SeniorDesign-2024/ControlBoard_Hardware/README.txt

Senior Design Control Board

The purpose of this board is to interface with all the different subsystems and manage inputs and outputs to and from the user.
