SeniorDesign-2024/ControlBoard_Hardware/ControlBoard_Hardware/ControlBoard_Hardware.kicad_pcb

## KiCad design ControlBoard_Hardware/ControlBoard_Hardware.kicad_pcb (2024-02-27)

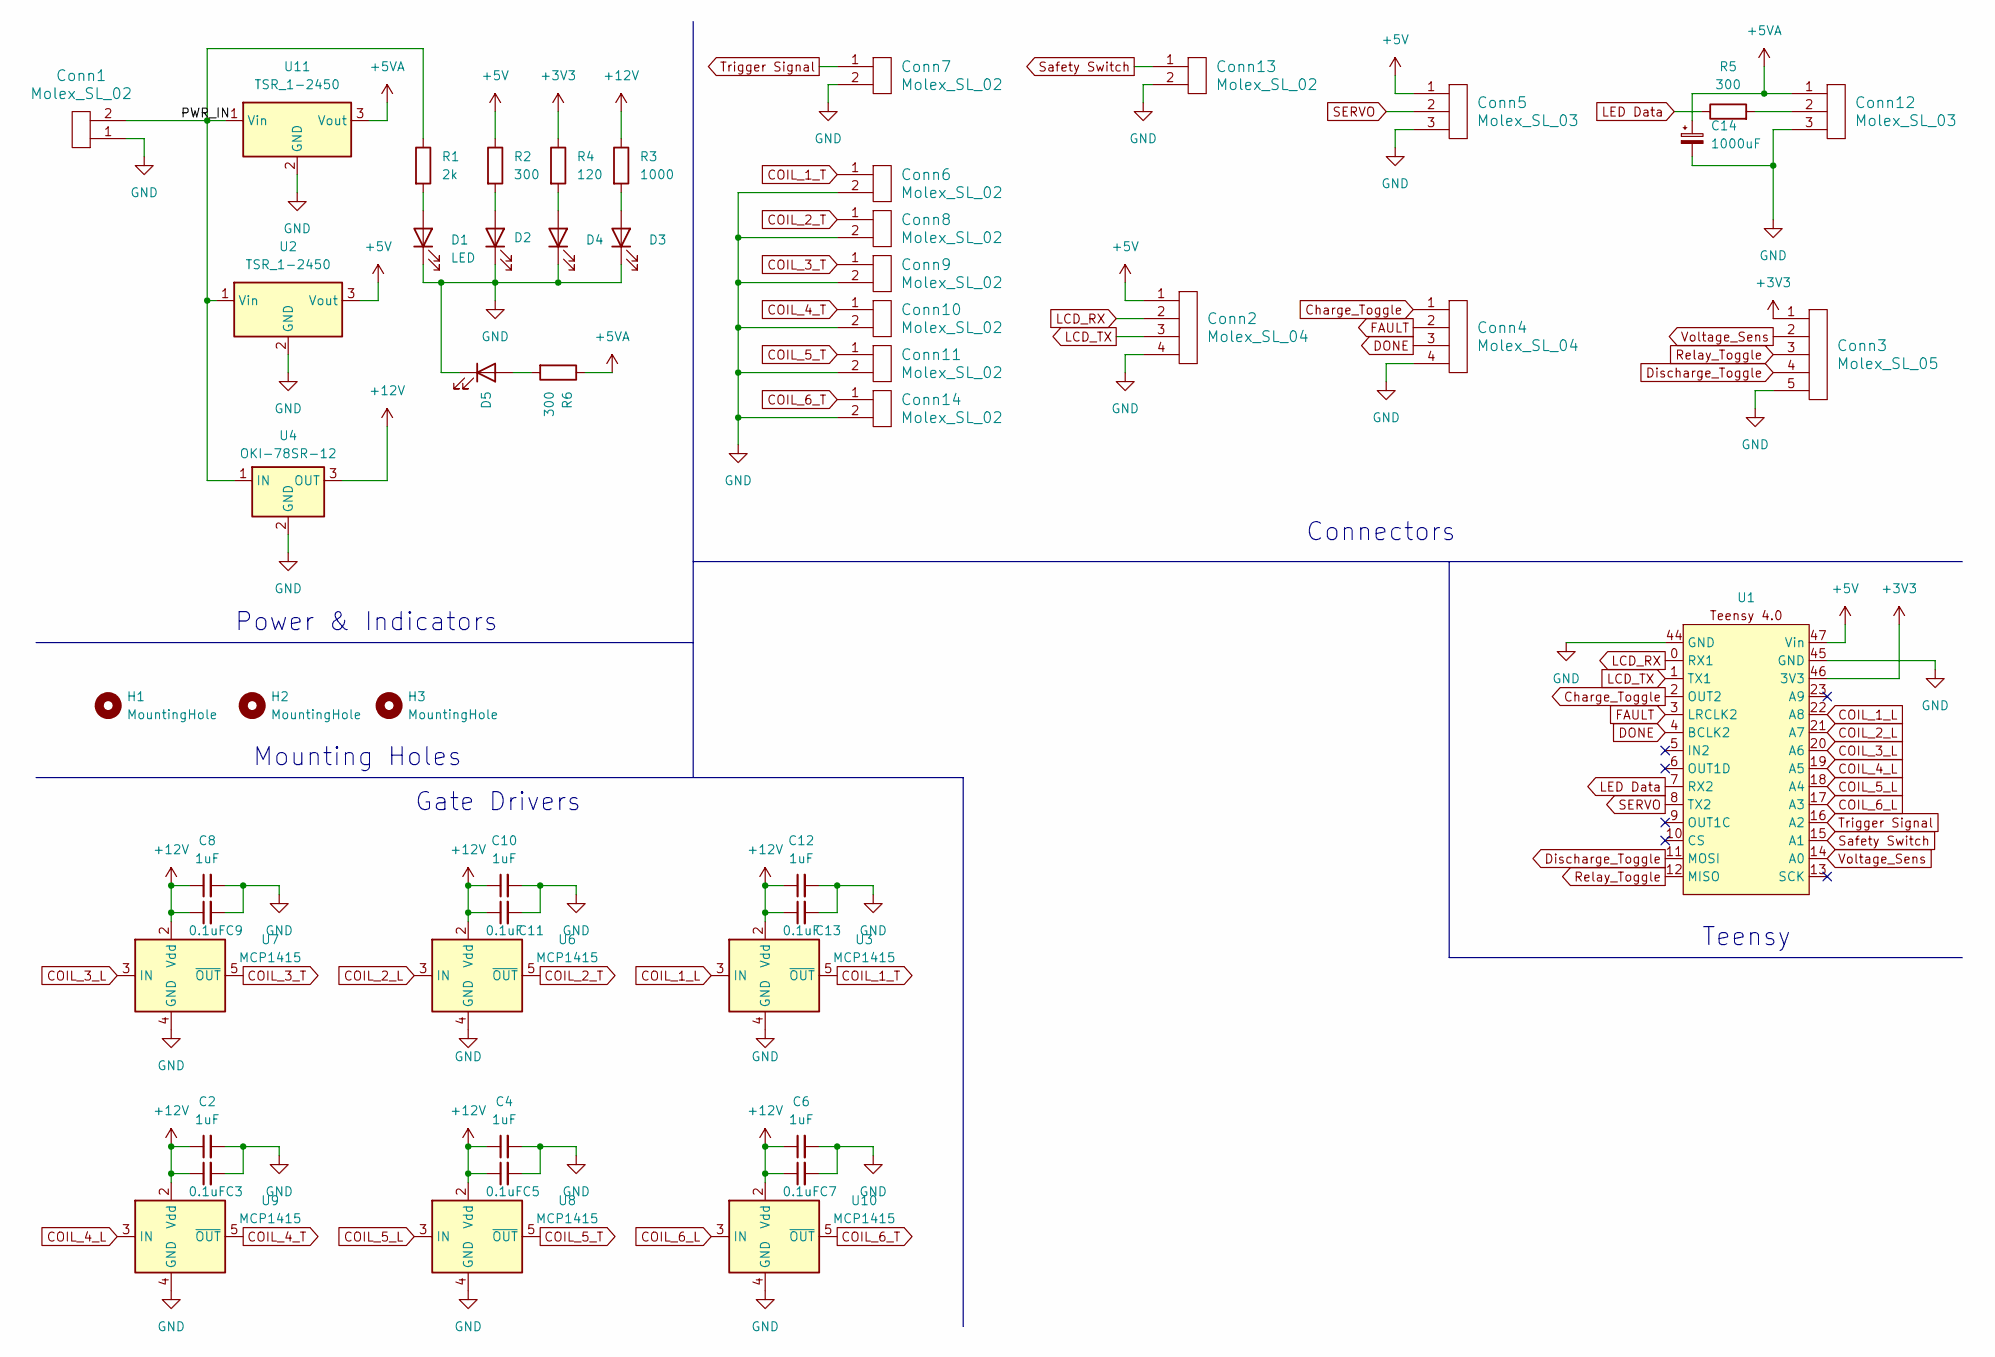
[picture p1: schematic ControlBoard_Hardware.kicad_sch]

Parts:
C2, C4, C6, C8, C10, C12: 1uF; C_0603_1608Metric_Pad1.08x0.95mm_HandSolder
C3, C5, C7, C9, C11, C13: 0.1uF; C_0603_1608Metric_Pad1.08x0.95mm_HandSolder
C14: 1000uF; CP_Radial_D8.0mm_P3.50mm
Conn1, Conn6, Conn7, Conn8, Conn9, Conn10, Conn11, Conn13, Conn14: Molex_SL_02; MOLEX_SL_02_Horizontal
Conn2, Conn4: Molex_SL_04; MOLEX_SL_04_Horizontal
Conn3: Molex_SL_05; MOLEX_SL_05_Horizontal
Conn5, Conn12: Molex_SL_03; MOLEX_SL_03_Horizontal
D1, D2, D3, D4, D5: LED; LED_0603_1608Metric_Pad1.05x0.95mm_HandSolder
H1, H2, H3: MountingHole; MountingHole_3.2mm_M3
R1: 2k; R_0603_1608Metric_Pad0.98x0.95mm_HandSolder
R2, R5, R6: 300; R_0603_1608Metric_Pad0.98x0.95mm_HandSolder
R3: 1000; R_0603_1608Metric_Pad0.98x0.95mm_HandSolder
R4: 120; R_0603_1608Metric_Pad0.98x0.95mm_HandSolder
U1: Teensy_4_0
U2, U11: TSR_1-2450; Converter_DCDC_TRACO_TSR-1_THT
U3, U6, U7, U8, U9, U10: MCP1415; SOT-23-5
U4: OKI-78SR-12; Converter_DCDC_Murata_OKI-78SR_Horizontal

Connections:
+3V3: Conn3.1, R4.1, U1.46 (3V3)
+5V: Conn2.1, Conn5.1, R2.1, U1.47 (Vin), U2.3 (Vout)
+5VA: C14.1, Conn12.1, R6.1, U11.3 (Vout)
+12V: C2.1, C3.1, C4.1, C5.1, C6.1, C7.1, C8.1, C9.1, C10.1, C11.1, C12.1, C13.1, R3.1, U3.2 (Vdd), U4.3 (OUT), U6.2 (Vdd), U7.2 (Vdd), U8.2 (Vdd), U9.2 (Vdd), U10.2 (Vdd)
/PWR_IN: Conn1.2, R1.1, U2.1 (Vin), U4.1 (IN), U11.1 (Vin)
COIL_1_L: U1.22 (A8), U3.3 (IN)
COIL_1_T: Conn6.1, U3.5 (~OUT)
COIL_2_L: U1.21 (A7), U6.3 (IN)
COIL_2_T: Conn8.1, U6.5 (~OUT)
COIL_3_L: U1.20 (A6), U7.3 (IN)
COIL_3_T: Conn9.1, U7.5 (~OUT)
COIL_4_L: U1.19 (A5), U9.3 (IN)
COIL_4_T: Conn10.1, U9.5 (~OUT)
COIL_5_L: U1.18 (A4), U8.3 (IN)
COIL_5_T: Conn11.1, U8.5 (~OUT)
COIL_6_L: U1.17 (A3), U10.3 (IN)
COIL_6_T: Conn14.1, U10.5 (~OUT)
Charge_Toggle: Conn4.1, U1.2 (OUT2)
DONE: Conn4.3, U1.4 (BCLK2)
Discharge_Toggle: Conn3.4, U1.11 (MOSI)
FAULT: Conn4.2, U1.3 (LRCLK2)
GND: C2.2, C3.2, C4.2, C5.2, C6.2, C7.2, C8.2, C9.2, C10.2, C11.2, C12.2, C13.2, C14.2, Conn1.1, Conn2.4, Conn3.5, Conn4.4, Conn5.3, Conn6.2, Conn7.2, Conn8.2, Conn9.2, Conn10.2, Conn11.2, Conn12.3, Conn13.2, Conn14.2, D1.1 (K), D2.1 (K), D3.1 (K), D4.1 (K), D5.1 (K), U1.44 (GND), U1.45 (GND), U2.2 (GND), U3.4 (GND), U4.2 (GND), U6.4 (GND), U7.4 (GND), U8.4 (GND), U9.4 (GND), U10.4 (GND), U11.2 (GND)
LCD_RX: Conn2.2, U1.0 (RX1)
LCD_TX: Conn2.3, U1.1 (TX1)
LED Data: R5.1, U1.7 (RX2)
unnamed: Conn12.2, R5.2
unnamed: D1.2 (A), R1.2
unnamed: D2.2 (A), R2.2
unnamed: D3.2 (A), R3.2
unnamed: D4.2 (A), R4.2
unnamed: D5.2 (A), R6.2
Relay_Toggle: Conn3.3, U1.12 (MISO)
SERVO: Conn5.2, U1.8 (TX2)
Safety Switch: Conn13.1, U1.15 (A1)
Trigger Signal: Conn7.1, U1.16 (A2)
Voltage_Sens: Conn3.2, U1.14 (A0)

Notes on the sheet:
Teensy
Power & Indicators
Connectors
Gate Drivers
Mounting Holes

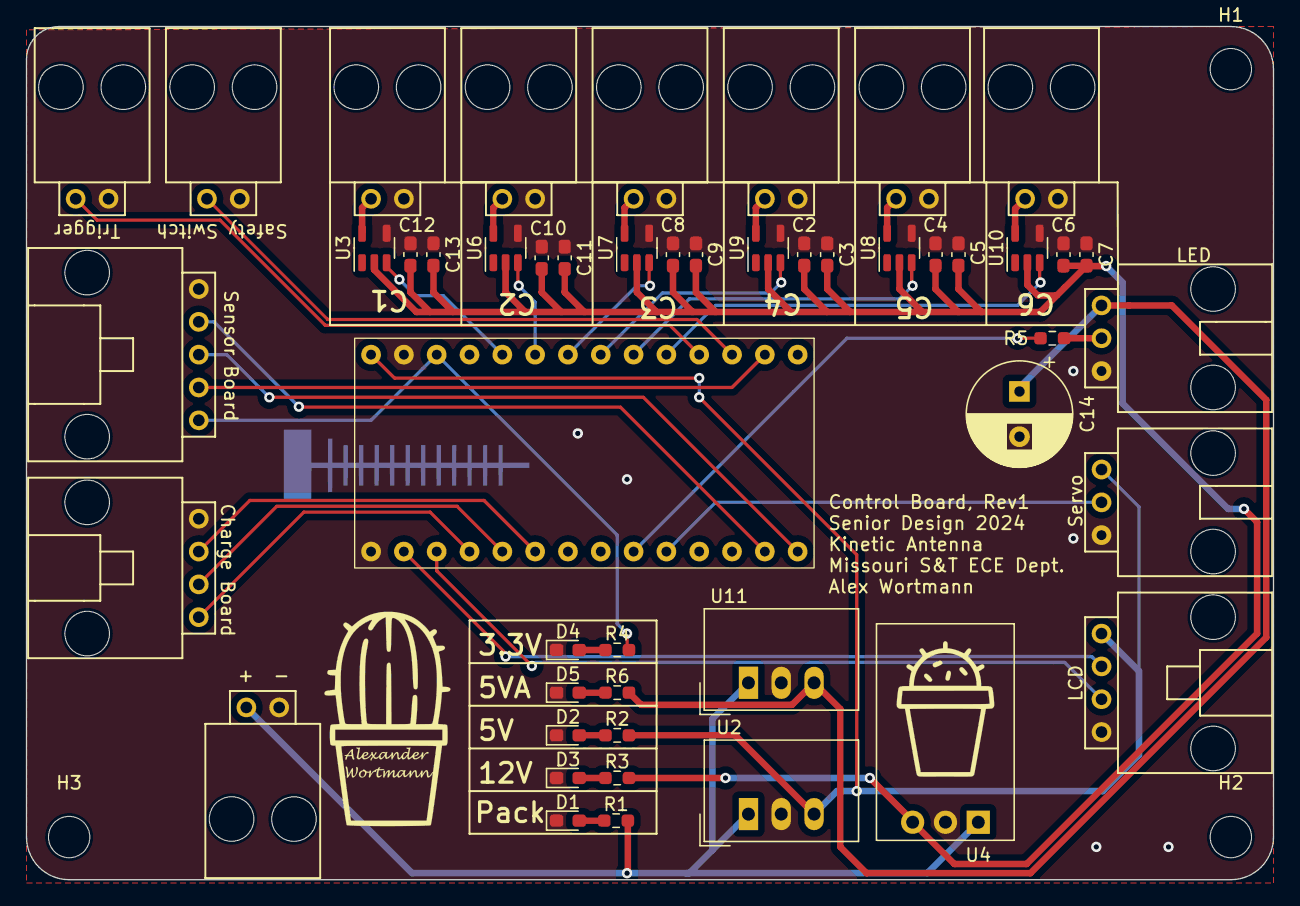
[picture p2: board ControlBoard_Hardware.kicad_pcb from above]

Board: 2 copper layers, 96.5 x 66.0 mm, 51 parts (0 on the bottom side), 36 nets.
