SeniorDesign-2024/ControlBoard_Hardware/(commit log)

2023-11-17 Made schematic
    [ControlBoard_Hardware.kicad_pcb, ControlBoard_Hardware.kicad_sch]
2023-11-17 Assigned footprints
    [ControlBoard_Hardware.kicad_sch]
2023-11-17 Revert "Assigned footprints"
    This reverts commit 6f2e1c40c0d01355b4ad57b50ebbed6eef59f7aa.
    [ControlBoard_Hardware.kicad_sch]
2023-12-01 Made layout
    [ControlBoard_Hardware.kicad_pcb, ControlBoard_Hardware.kicad_sch]
2023-12-08 updatedfor final report
    [ControlBoard_Hardware.kicad_pcb, ControlBoard_Hardware.kicad_sch]
2024-01-23 Updated Schematic
    [ControlBoard_Hardware.kicad_sch]
2024-01-23 fixed voltage level on coil sensors
    [ControlBoard_Hardware.kicad_sch]
2024-02-11 started layout
    [ControlBoard_Hardware.kicad_pcb]
2024-02-17 sus gate driver
    [ControlBoard_Hardware.kicad_sch]
2024-02-20 finished board layour
    [ControlBoard_Hardware.kicad_pcb, ControlBoard_Hardware.kicad_sch]
2024-02-20 added dimension marks
    [ControlBoard_Hardware.kicad_pcb]
2024-02-20 Added silk screens
    [ControlBoard_Hardware.kicad_pcb]
2024-02-22 changed review critiques
    [ControlBoard_Hardware.kicad_pcb]
2024-02-23 created bom
    [ControlBoard_Hardware.csv]
2024-02-27 generated gerbs
    [ControlBoard_Hardware-B_Cu.gbl, ControlBoard_Hardware-B_Mask.gbs, ControlBoard_Hardware-B_Paste.gbp, ControlBoard_Hardware-B_Silkscreen.gbo, ControlBoard_Hardware-Edge_Cuts.gm1, ControlBoard_Hardware-F_Cu.gtl, ControlBoard_Hardware-F_Mask.gts, ControlBoard_Hardware-F_Paste.gtp]
